tzinke/CarbAutomator/Documentation and Diagrams/Air+Fuel+Ratios1294064996.jpg

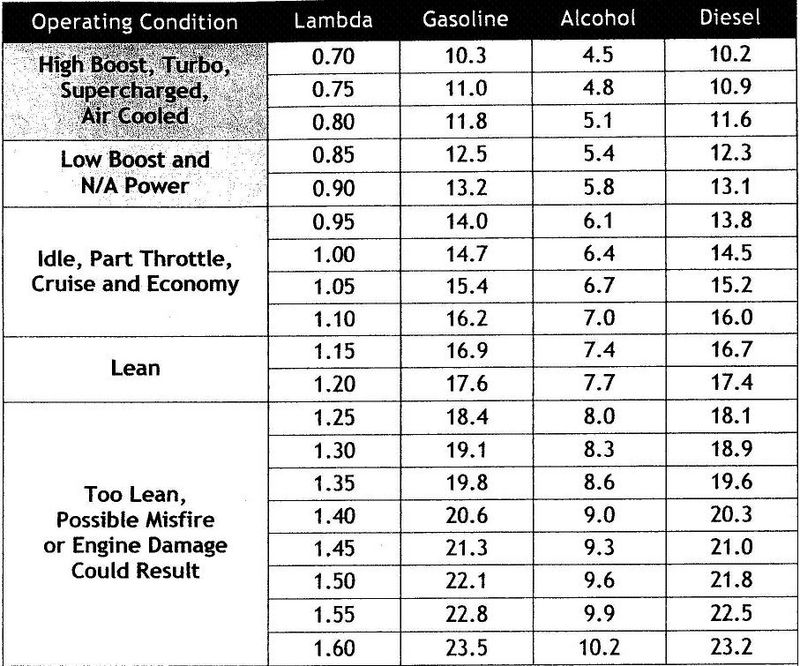
Documentation and Diagrams/Air+Fuel+Ratios1294064996.jpg
