tzinke/CarbAutomator/Documentation and Diagrams/System Diagram.PNG

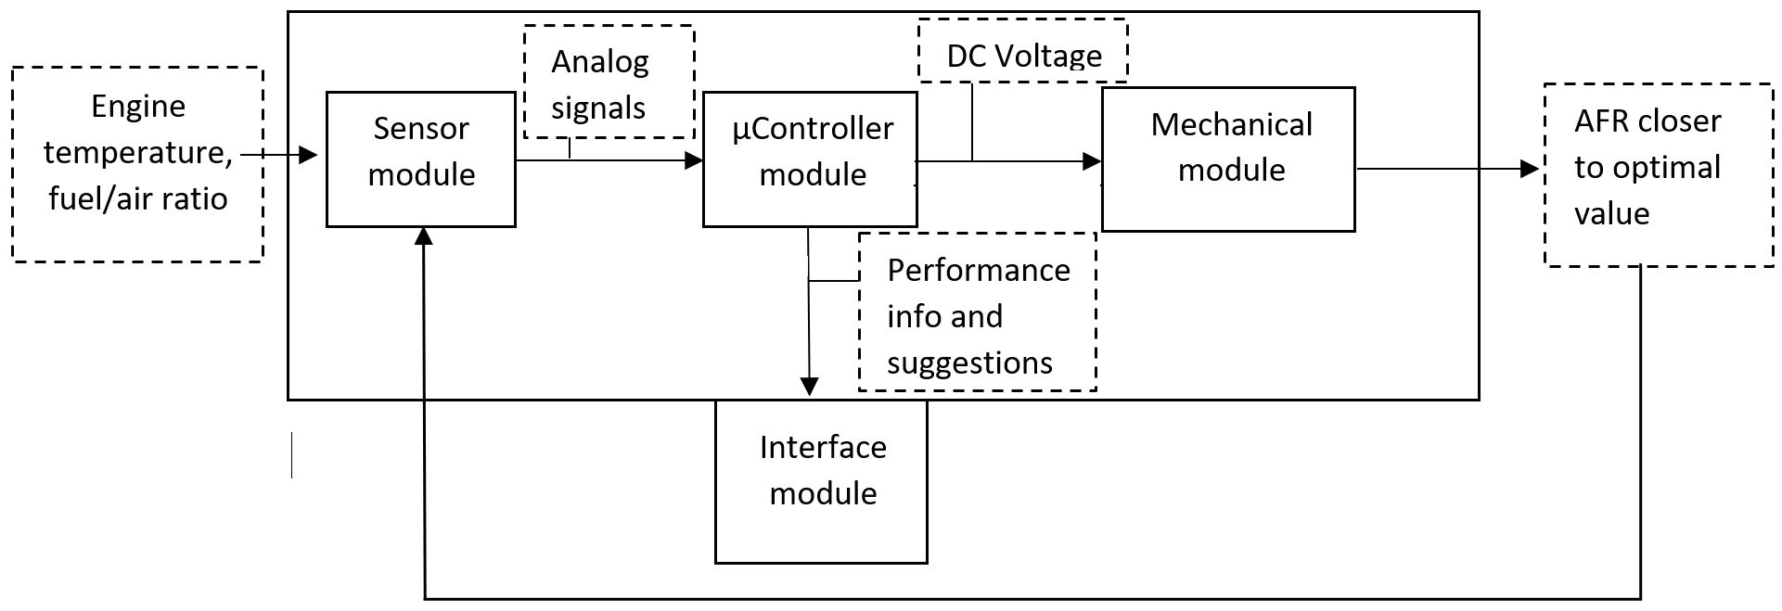
Documentation and Diagrams/System Diagram.PNG
