tzinke/CarbAutomator/Documentation and Diagrams/System Flowchart.png

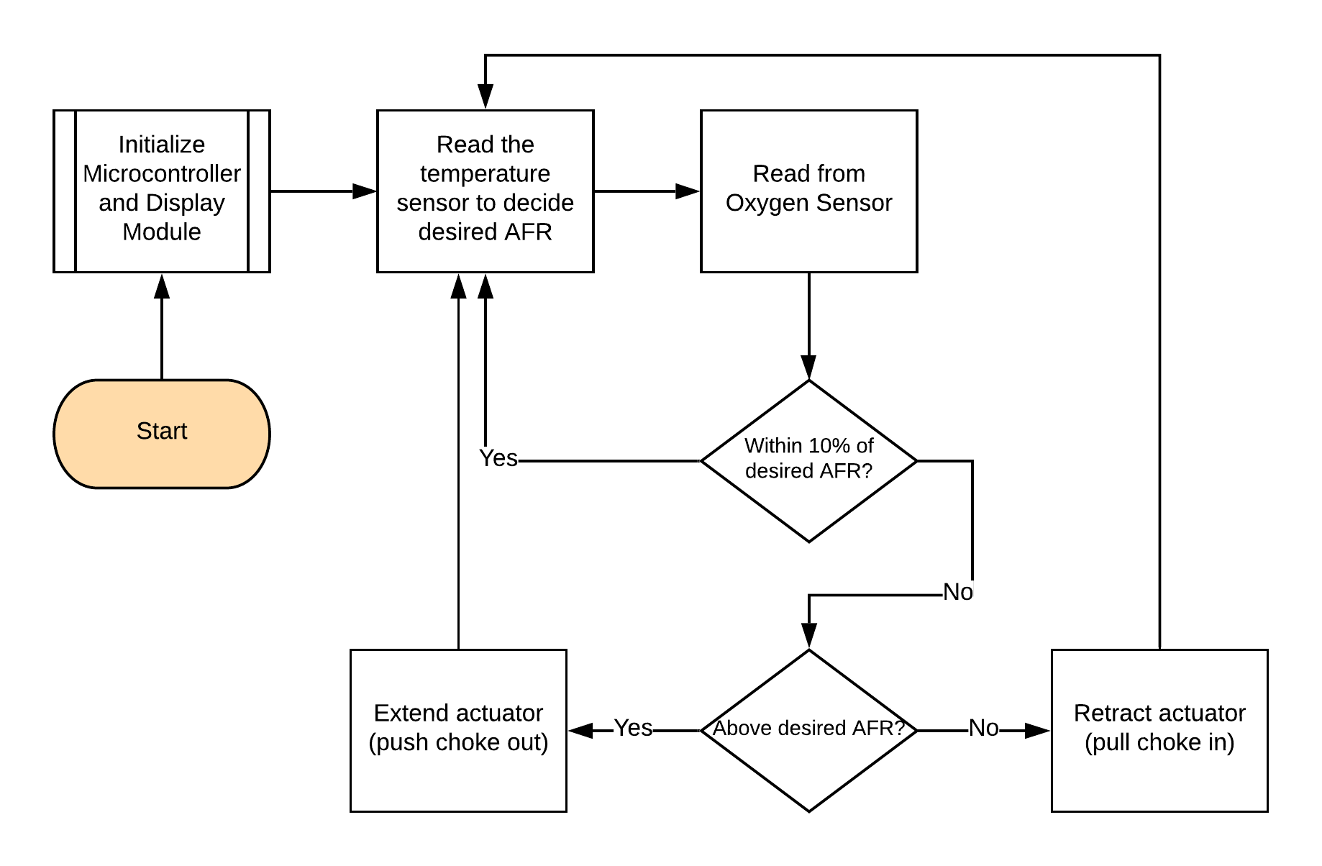
Documentation and Diagrams/System Flowchart.png
