tzinke/CarbAutomator/Documentation and Diagrams/VoltVLambda.gif

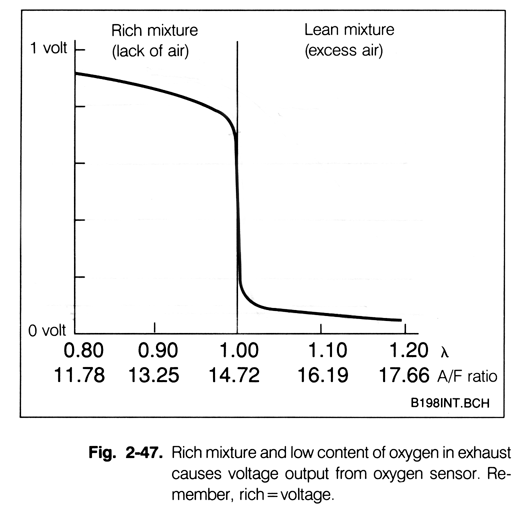
Documentation and Diagrams/VoltVLambda.gif
