tzinke/CarbAutomator/Documentation and Diagrams/Schematic_Portrait.pdf

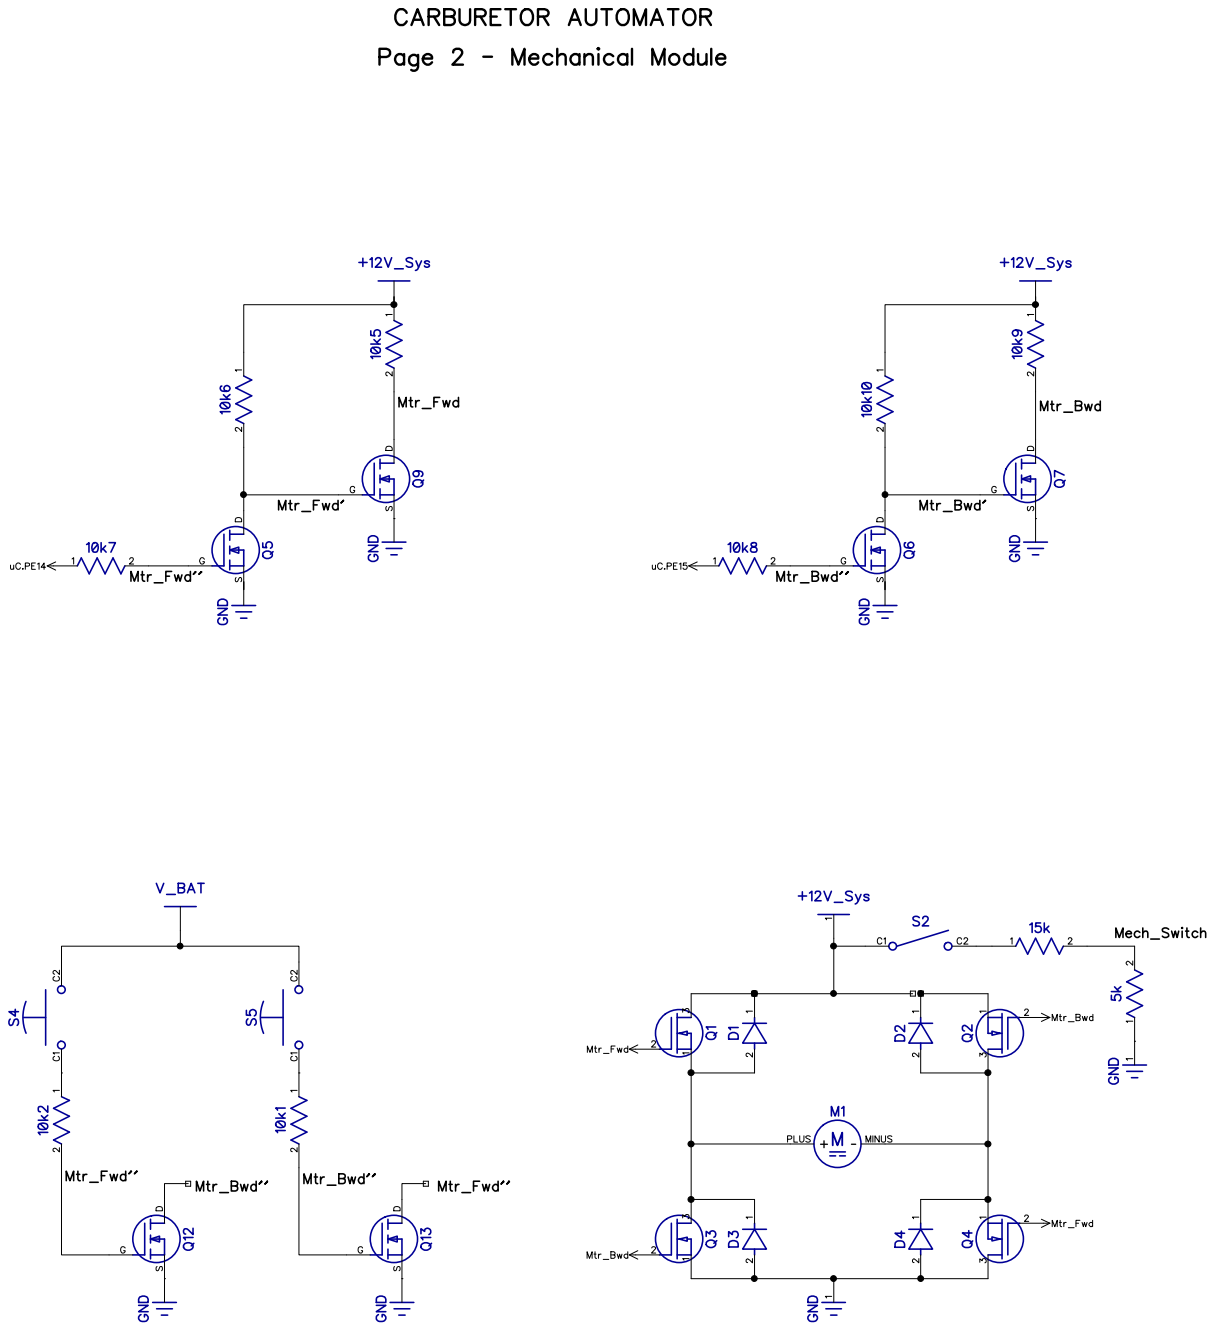
[picture p24: page 2]
