tzinke/CarbAutomator/Documentation and Diagrams/Schematic_Portrait.pdf

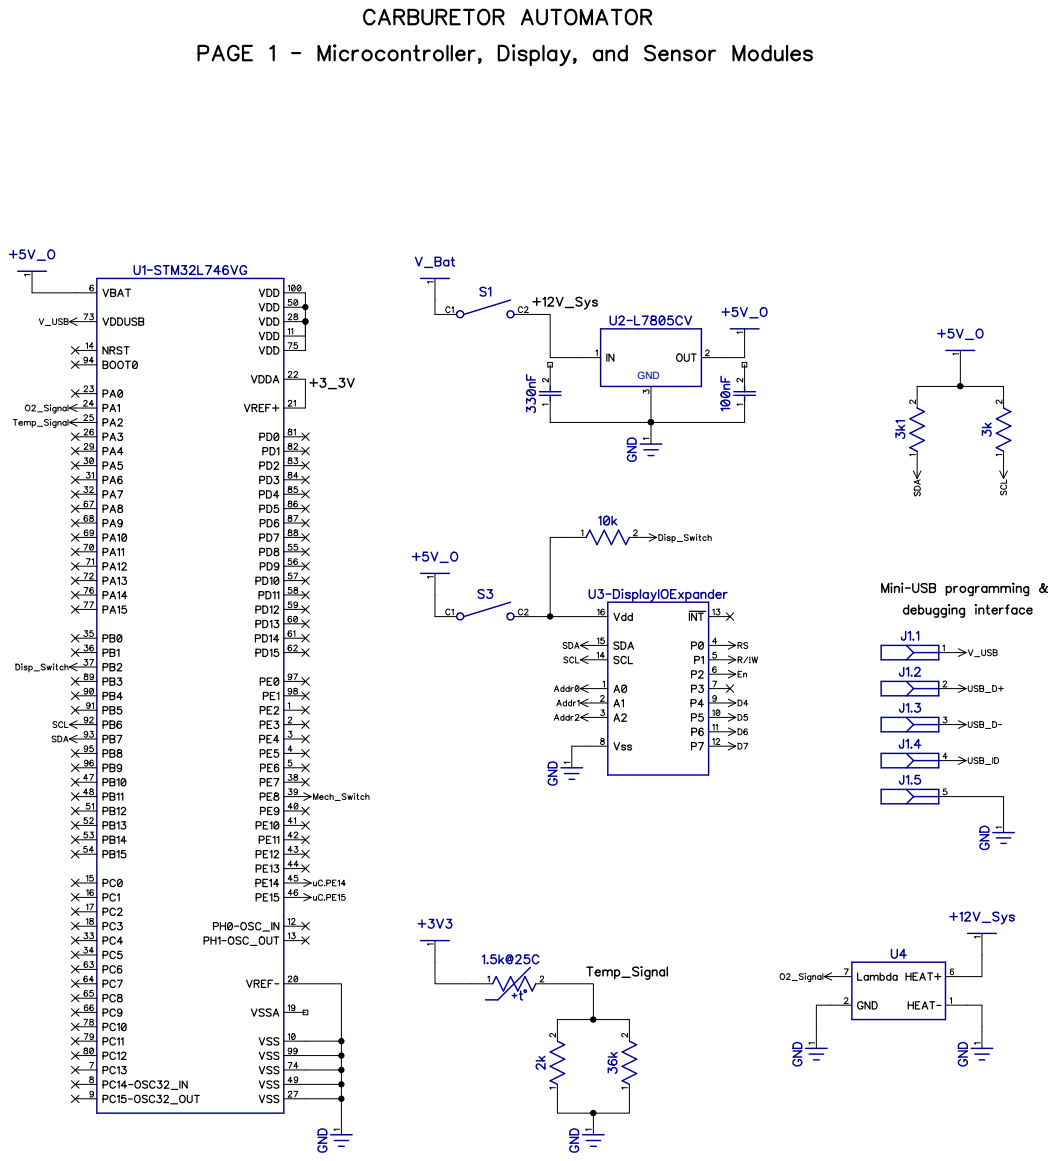
[picture p23: page 1]
GND
